ismailozgenc/FPGA-Based-Spoken-Number-Recognition-System/docs/fig_system_block_diagram.png

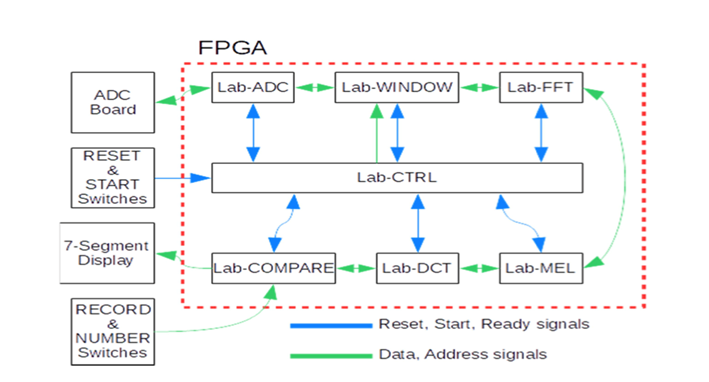
docs/fig_system_block_diagram.png
