ismailozgenc/FPGA-Based-Spoken-Number-Recognition-System/docs/pcbreel.jpeg

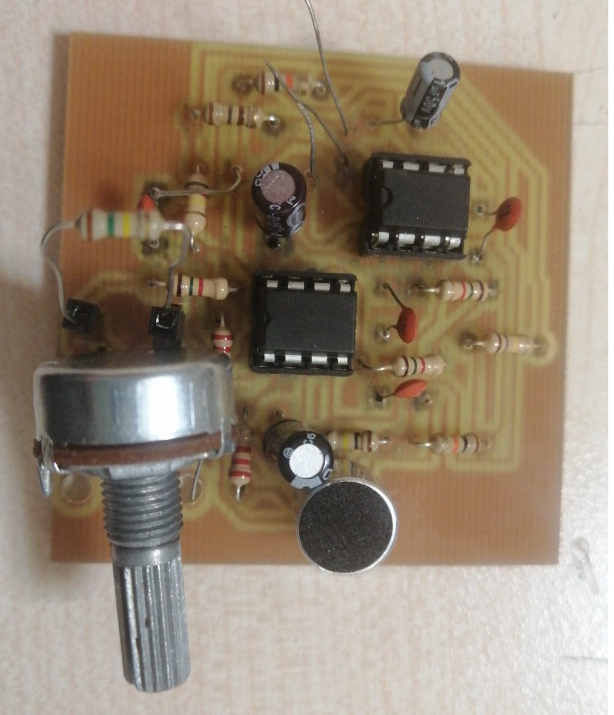
docs/pcbreel.jpeg
