ismailozgenc/FPGA-Based-Spoken-Number-Recognition-System/docs/SNRinFPGA.jpeg

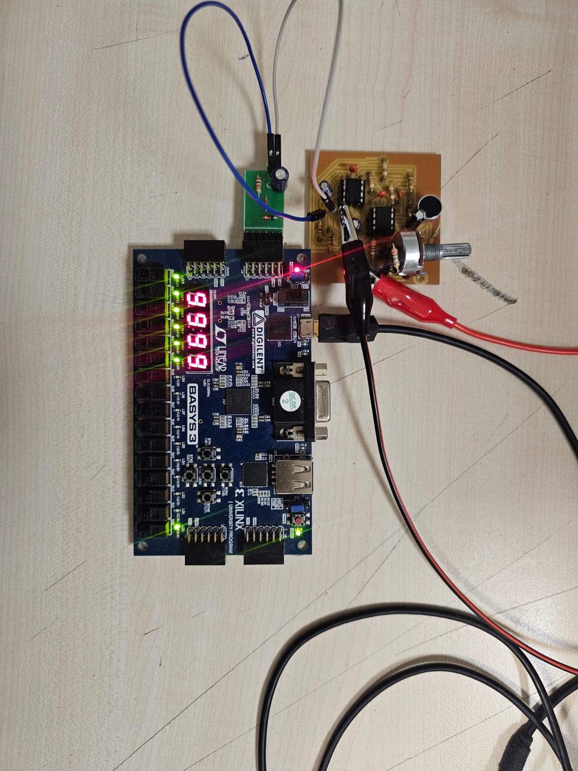
docs/SNRinFPGA.jpeg
