ismailozgenc/FPGA-Based-Spoken-Number-Recognition-System/hardware/Analog front-end schematic.png

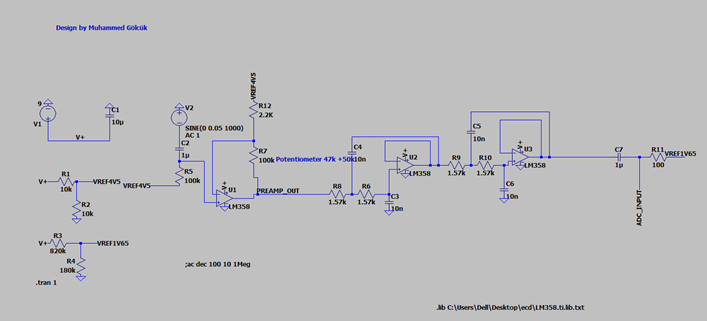
hardware/Analog front-end schematic.png
