ismailozgenc/FPGA-Based-Spoken-Number-Recognition-System/Matlab Codes/images/adc_.png

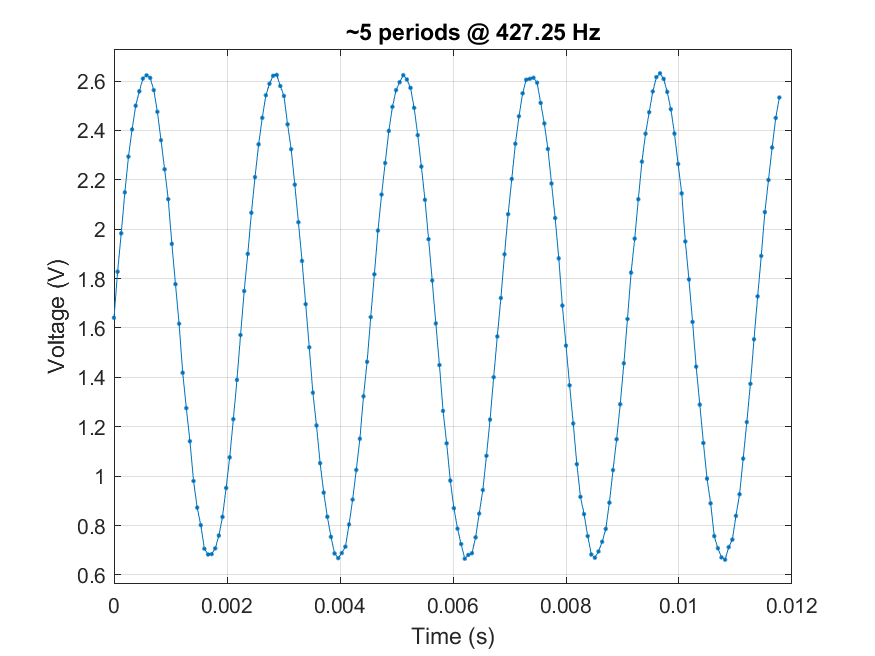
Matlab Codes/images/adc_.png
