ismailozgenc/FPGA-Based-Spoken-Number-Recognition-System/Matlab Codes/images/adc_vin.png

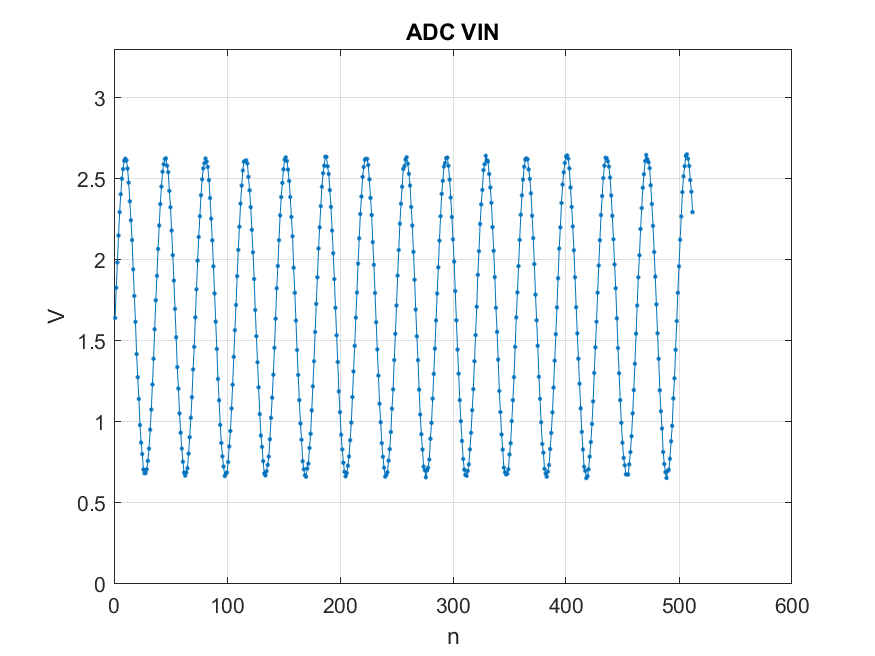
Matlab Codes/images/adc_vin.png
