ismailozgenc/FPGA-Based-Spoken-Number-Recognition-System/Matlab Codes/images/adc_vin_.png

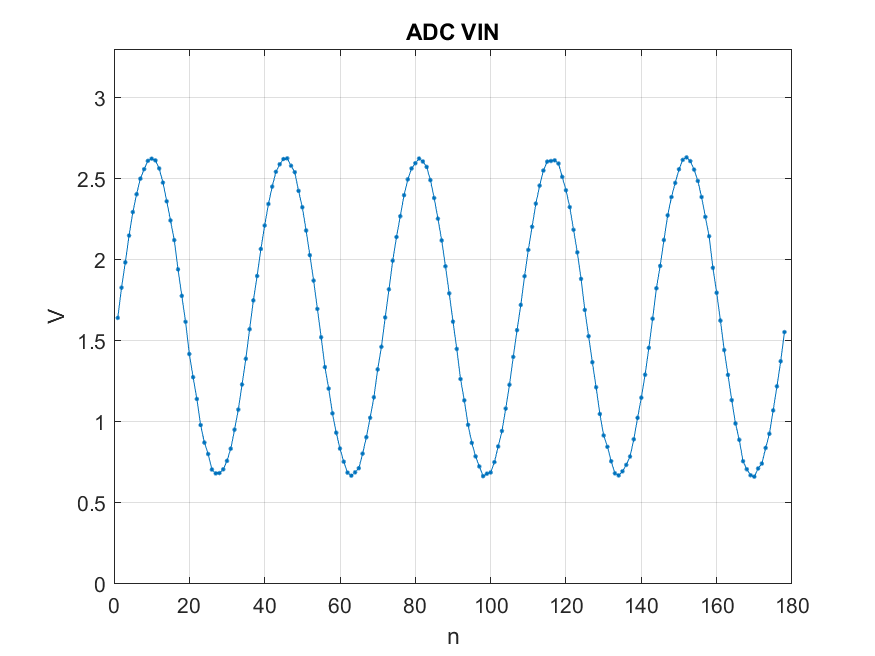
Matlab Codes/images/adc_vin_.png
