ismailozgenc/FPGA-Based-Spoken-Number-Recognition-System/Matlab Codes/images/dct_8.png

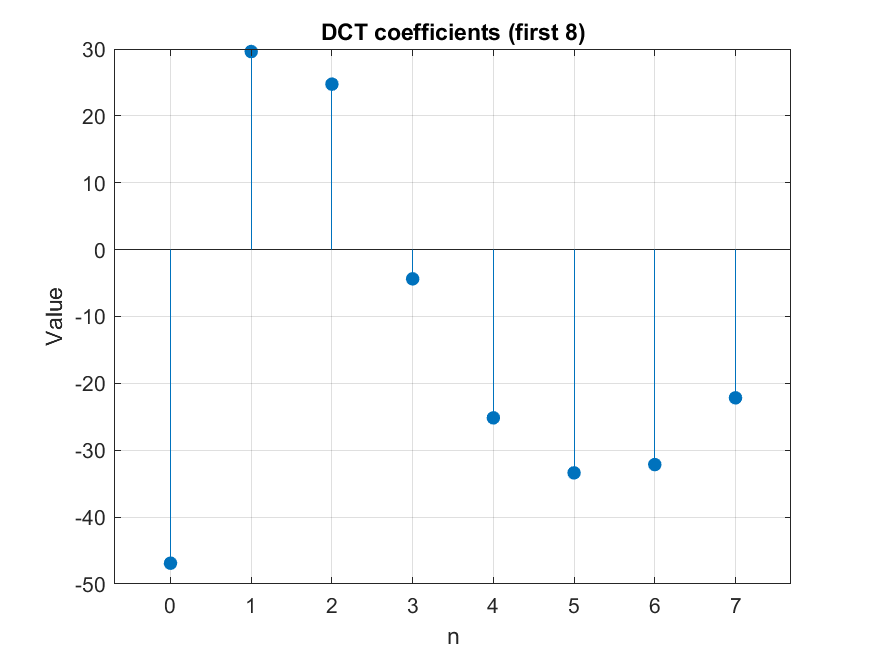
Matlab Codes/images/dct_8.png
