ismailozgenc/FPGA-Based-Spoken-Number-Recognition-System/Matlab Codes/images/fft_mags2_bins_0_255.png

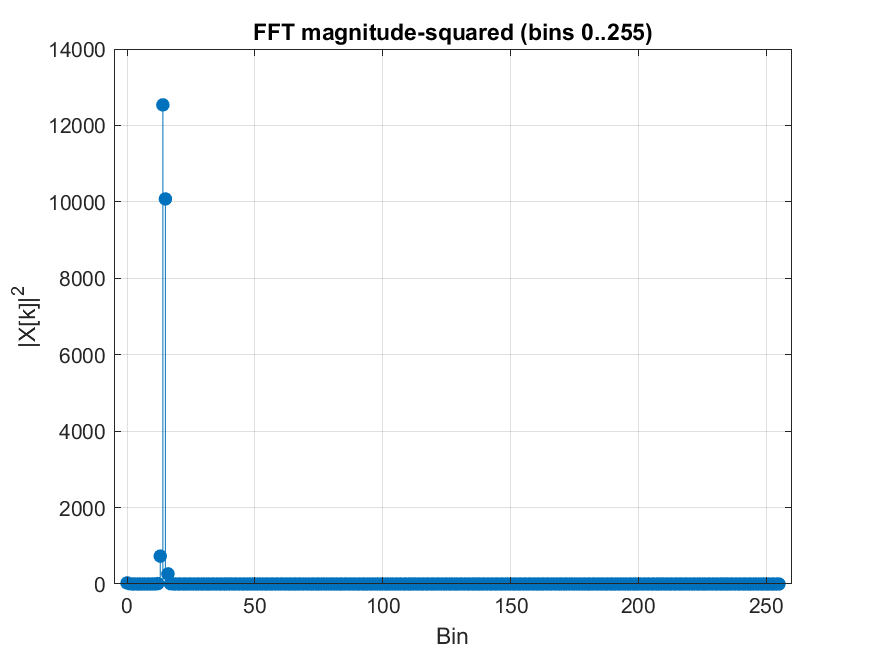
Matlab Codes/images/fft_mags2_bins_0_255.png
