ismailozgenc/FPGA-Based-Spoken-Number-Recognition-System/Matlab Codes/images/fft_spectrum_db.png

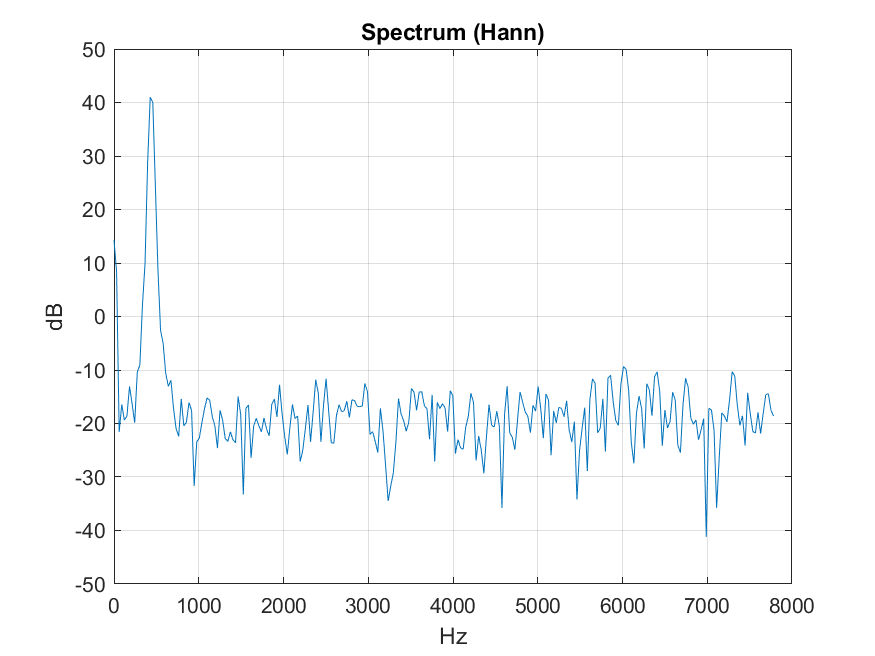
Matlab Codes/images/fft_spectrum_db.png
