ismailozgenc/FPGA-Based-Spoken-Number-Recognition-System/Matlab Codes/images/mel_energies.png

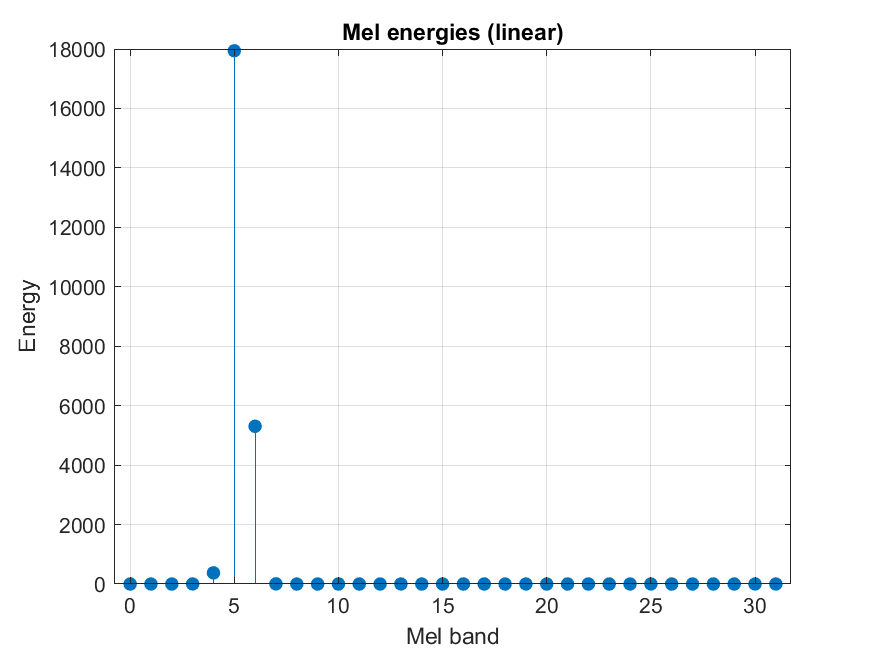
Matlab Codes/images/mel_energies.png
