ismailozgenc/FPGA-Based-Spoken-Number-Recognition-System/Matlab Codes/images/mel_log.png

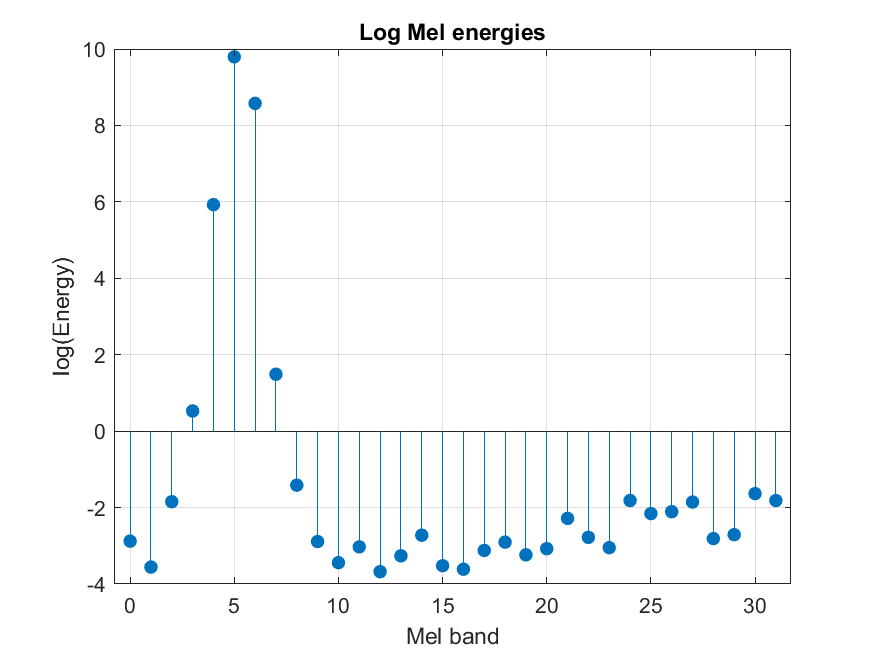
Matlab Codes/images/mel_log.png
