ismailozgenc/FPGA-Based-Spoken-Number-Recognition-System/Matlab Codes/images/windowed.png

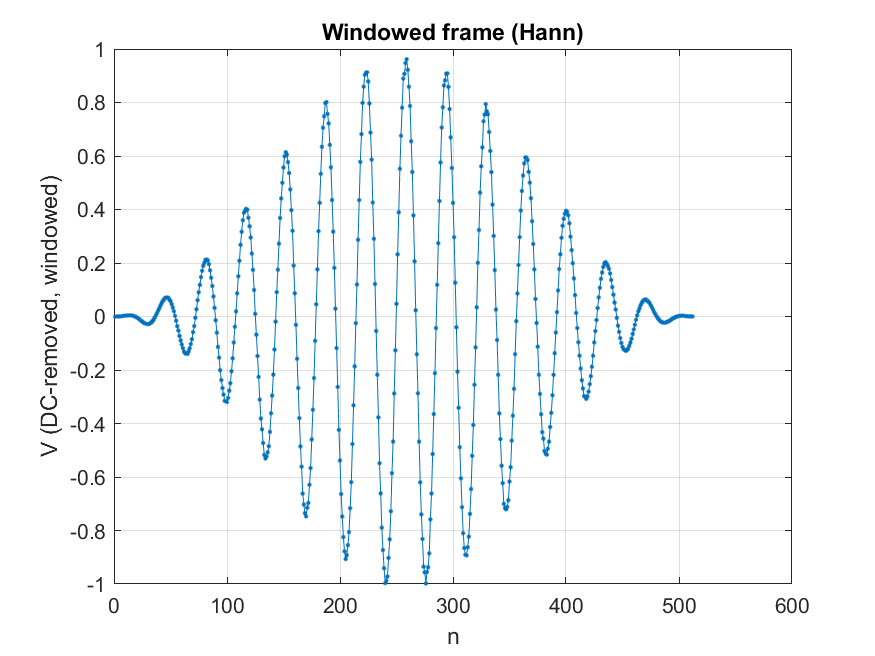
Matlab Codes/images/windowed.png
