ismailozgenc/FPGA-Based-Spoken-Number-Recognition-System/IPs/IP-Lab_MEL/src/Lab_MEL.vhd

library ieee;
use ieee.std_logic_1164.all;
use ieee.numeric_std.all;

entity Lab_MEL is
    port (
        reset_in     : in  std_logic;
        clock_in     : in  std_logic;
        fft_addr_out : out std_logic_vector(7 downto 0);
        fft_data_in  : in  std_logic_vector(31 downto 0);
        mem_addr_in  : in  std_logic_vector(4 downto 0);
        mem_data_out : out std_logic_vector(31 downto 0);
        start_in     : in  std_logic;
        ready_out    : out std_logic
    );
end entity;

architecture rtl of Lab_MEL is

    constant NUM_FILTERS : integer := 32;
    constant NUM_BINS    : integer := 256;
    constant COEF_WIDTH  : integer := 12;
    constant ACC_WIDTH   : integer := 48;

    type coeff_row_t is array (0 to NUM_BINS-1) of signed(COEF_WIDTH-1 downto 0);
    type coeff_rom_t is array (0 to NUM_FILTERS-1) of coeff_row_t;

    constant coeff_rom : coeff_rom_t := (
        0 => (to_signed(2047, COEF_WIDTH), to_signed(1024, COEF_WIDTH), to_signed(0, COEF_WIDTH), to_signed(0, COEF_WIDTH), to_signed(0, COEF_WIDTH), to_signed(0, COEF_WIDTH), to_signed(0, COEF_WIDTH), to_signed(0, COEF_WIDTH), to_signed(0, COEF_WIDTH), to_signed(0, COEF_WIDTH), to_signed(0, COEF_WIDTH), to_signed(0, COEF_WIDTH), to_signed(0, COEF_WIDTH), to_signed(0, COEF_WIDTH), to_signed(0, COEF_WIDTH), to_signed(0, COEF_WIDTH), to_signed(0, COEF_WIDTH), to_signed(0, COEF_WIDTH), to_signed(0, COEF_WIDTH), to_signed(0, COEF_WIDTH), to_signed(0, COEF_WIDTH), to_signed(0, COEF_WIDTH), to_signed(0, COEF_WIDTH), to_signed(0, COEF_WIDTH), to_signed(0, COEF_WIDTH), to_signed(0, COEF_WIDTH), to_signed(0, COEF_WIDTH), to_signed(0, COEF_WIDTH), to_signed(0, COEF_WIDTH), to_signed(0, COEF_WIDTH), to_signed(0, COEF_WIDTH), to_signed(0, COEF_WIDTH), to_signed(0, COEF_WIDTH), to_signed(0, COEF_WIDTH), to_signed(0, COEF_WIDTH), to_signed(0, COEF_WIDTH), to_signed(0, COEF_WIDTH), to_signed(0, COEF_WIDTH), to_signed(0, COEF_WIDTH), to_signed(0, COEF_WIDTH), to_signed(0, COEF_WIDTH), to_signed(0, COEF_WIDTH), to_signed(0, COEF_WIDTH), to_signed(0, COEF_WIDTH), to_signed(0, COEF_WIDTH), to_signed(0, COEF_WIDTH), to_signed(0, COEF_WIDTH), to_signed(0, COEF_WIDTH), to_signed(0, COEF_WIDTH), to_signed(0, COEF_WIDTH), to_signed(0, COEF_WIDTH), to_signed(0, COEF_WIDTH), to_signed(0, COEF_WIDTH), to_signed(0, COEF_WIDTH), to_signed(0, COEF_WIDTH), to_signed(0, COEF_WIDTH), to_signed(0, COEF_WIDTH)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
to_signed(0, COEF_WIDTH), to_signed(0, COEF_WIDTH), to_signed(0, COEF_WIDTH), to_signed(0, COEF_WIDTH), to_signed(0, COEF_WIDTH), to_signed(0, COEF_WIDTH), to_signed(0, COEF_WIDTH), to_signed(0, COEF_WIDTH), to_signed(0, COEF_WIDTH), to_signed(0, COEF_WIDTH), to_signed(0, COEF_WIDTH), to_signed(0, COEF_WIDTH), to_signed(0, COEF_WIDTH), to_signed(0, COEF_WIDTH), to_signed(0, COEF_WIDTH), to_signed(0, COEF_WIDTH), to_signed(0, COEF_WIDTH), to_signed(0, COEF_WIDTH), to_signed(0, COEF_WIDTH), to_signed(0, COEF_WIDTH), to_signed(0, COEF_WIDTH), to_signed(0, COEF_WIDTH), to_signed(0, COEF_WIDTH), to_signed(0, COEF_WIDTH), to_signed(0, COEF_WIDTH), to_signed(0, COEF_WIDTH)),
        1 => (to_signed(0, COEF_WIDTH), to_signed(1024, COEF_WIDTH), to_signed(2047, COEF_WIDTH), to_signed(1024, COEF_WIDTH), to_signed(0, COEF_WIDTH), to_signed(0, COEF_WIDTH), to_signed(0, COEF_WIDTH), to_signed(0, COEF_WIDTH), to_signed(0, COEF_WIDTH), to_signed(0, COEF_WIDTH), to_signed(0, COEF_WIDTH), to_signed(0, COEF_WIDTH), to_signed(0, COEF_WIDTH), to_signed(0, COEF_WIDTH), to_signed(0, COEF_WIDTH), to_signed(0, COEF_WIDTH), to_signed(0, COEF_WIDTH), to_signed(0, COEF_WIDTH), to_signed(0, COEF_WIDTH), to_signed(0, COEF_WIDTH), to_signed(0, COEF_WIDTH), to_signed(0, COEF_WIDTH), to_signed(0, COEF_WIDTH), to_signed(0, COEF_WIDTH), to_signed(0, COEF_WIDTH), to_signed(0, COEF_WIDTH), to_signed(0, COEF_WIDTH), to_signed(0, COEF_WIDTH), to_signed(0, COEF_WIDTH), to_signed(0, COEF_WIDTH), to_signed(0, COEF_WIDTH), to_signed(0, COEF_WIDTH), to_signed(0, COEF_WIDTH), to_signed(0, COEF_WIDTH), to_signed(0, COEF_WIDTH), to_signed(0, COEF_WIDTH), to_signed(0, COEF_WIDTH), to_signed(0, COEF_WIDTH), to_signed(0, COEF_WIDTH), to_signed(0, COEF_WIDTH), to_signed(0, COEF_WIDTH), to_signed(0, COEF_WIDTH), to_signed(0, COEF_WIDTH), to_signed(0, COEF_WIDTH), to_signed(0, COEF_WIDTH), to_signed(0, COEF_WIDTH), to_signed(0, COEF_WIDTH), to_signed(0, COEF_WIDTH), to_signed(0, COEF_WIDTH), to_signed(0, COEF_WIDTH), to_signed(0, COEF_WIDTH), to_signed(0, COEF_WIDTH), to_signed(0, COEF_WIDTH), to_signed(0, COEF_WIDTH), to_signed(0, COEF_WIDTH), to_signed(0, COEF_WIDTH), to_signed(0, COEF_WID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
), to_signed(0, COEF_WIDTH), to_signed(0, COEF_WIDTH), to_signed(0, COEF_WIDTH), to_signed(0, COEF_WIDTH), to_signed(0, COEF_WIDTH), to_signed(0, COEF_WIDTH), to_signed(0, COEF_WIDTH), to_signed(0, COEF_WIDTH), to_signed(0, COEF_WIDTH), to_signed(0, COEF_WIDTH), to_signed(0, COEF_WIDTH), to_signed(0, COEF_WIDTH), to_signed(0, COEF_WIDTH), to_signed(0, COEF_WIDTH), to_signed(0, COEF_WIDTH), to_signed(0, COEF_WIDTH), to_signed(0, COEF_WIDTH), to_signed(0, COEF_WIDTH), to_signed(0, COEF_WIDTH), to_signed(0, COEF_WIDTH), to_signed(0, COEF_WIDTH), to_signed(0, COEF_WIDTH), to_signed(0, COEF_WIDTH), to_signed(0, COEF_WIDTH), to_signed(0, COEF_WIDTH), to_signed(0, COEF_WIDTH)),
        2 => (to_signed(0, COEF_WIDTH), to_signed(0, COEF_WIDTH), to_signed(0, COEF_WIDTH), to_signed(1024, COEF_WIDTH), to_signed(2047, COEF_WIDTH), to_signed(1365, COEF_WIDTH), to_signed(683, COEF_WIDTH), to_signed(0, COEF_WIDTH), to_signed(0, COEF_WIDTH), to_signed(0, COEF_WIDTH), to_signed(0, COEF_WIDTH), to_signed(0, COEF_WIDTH), to_signed(0, COEF_WIDTH), to_signed(0, COEF_WIDTH), to_signed(0, COEF_WIDTH), to_signed(0, COEF_WIDTH), to_signed(0, COEF_WIDTH), to_signed(0, COEF_WIDTH), to_signed(0, COEF_WIDTH), to_signed(0, COEF_WIDTH), to_signed(0, COEF_WIDTH), to_signed(0, COEF_WIDTH), to_signed(0, COEF_WIDTH), to_signed(0, COEF_WIDTH), to_signed(0, COEF_WIDTH), to_signed(0, COEF_WIDTH), to_signed(0, COEF_WIDTH), to_signed(0, COEF_WIDTH), to_signed(0, COEF_WIDTH), to_signed(0, COEF_WIDTH), to_signed(0, COEF_WIDTH), to_signed(0, COEF_WIDTH), to_signed(0, COEF_WIDTH), to_signed(0, COEF_WIDTH), to_signed(0, COEF_WIDTH), to_signed(0, COEF_WIDTH), to_signed(0, COEF_WIDTH), to_signed(0, COEF_WIDTH), to_signed(0, COEF_WIDTH), to_signed(0, COEF_WIDTH), to_signed(0, COEF_WIDTH), to_signed(0, COEF_WIDTH), to_signed(0, COEF_WIDTH), to_signed(0, COEF_WIDTH), to_signed(0, COEF_WIDTH), to_signed(0, COEF_WIDTH), to_signed(0, COEF_WIDTH), to_signed(0, COEF_WIDTH), to_signed(0, COEF_WIDTH), to_signed(0, COEF_WIDTH), to_signed(0, COEF_WIDTH), to_signed(0, COEF_WIDTH), to_signed(0, COEF_WIDTH), to_signed(0, COEF_WIDTH), to_signed(0, COEF_WIDTH), to_signed(0, COEF_WIDTH), to_signed(0, COEF_W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
TH), to_signed(0, COEF_WIDTH), to_signed(0, COEF_WIDTH), to_signed(0, COEF_WIDTH), to_signed(0, COEF_WIDTH), to_signed(0, COEF_WIDTH), to_signed(0, COEF_WIDTH), to_signed(0, COEF_WIDTH), to_signed(0, COEF_WIDTH), to_signed(0, COEF_WIDTH), to_signed(0, COEF_WIDTH), to_signed(0, COEF_WIDTH), to_signed(0, COEF_WIDTH), to_signed(0, COEF_WIDTH), to_signed(0, COEF_WIDTH), to_signed(0, COEF_WIDTH), to_signed(0, COEF_WIDTH), to_signed(0, COEF_WIDTH), to_signed(0, COEF_WIDTH), to_signed(0, COEF_WIDTH), to_signed(0, COEF_WIDTH), to_signed(0, COEF_WIDTH), to_signed(0, COEF_WIDTH), to_signed(0, COEF_WIDTH), to_signed(0, COEF_WIDTH), to_signed(0, COEF_WIDTH), to_signed(0, COEF_WIDTH)),
        3 => (to_signed(0, COEF_WIDTH), to_signed(0, COEF_WIDTH), to_signed(0, COEF_WIDTH), to_signed(0, COEF_WIDTH), to_signed(0, COEF_WIDTH), to_signed(683, COEF_WIDTH), to_signed(1365, COEF_WIDTH), to_signed(2047, COEF_WIDTH), to_signed(1024, COEF_WIDTH), to_signed(0, COEF_WIDTH), to_signed(0, COEF_WIDTH), to_signed(0, COEF_WIDTH), to_signed(0, COEF_WIDTH), to_signed(0, COEF_WIDTH), to_signed(0, COEF_WIDTH), to_signed(0, COEF_WIDTH), to_signed(0, COEF_WIDTH), to_signed(0, COEF_WIDTH), to_signed(0, COEF_WIDTH), to_signed(0, COEF_WIDTH), to_signed(0, COEF_WIDTH), to_signed(0, COEF_WIDTH), to_signed(0, COEF_WIDTH), to_signed(0, COEF_WIDTH), to_signed(0, COEF_WIDTH), to_signed(0, COEF_WIDTH), to_signed(0, COEF_WIDTH), to_signed(0, COEF_WIDTH), to_signed(0, COEF_WIDTH), to_signed(0, COEF_WIDTH), to_signed(0, COEF_WIDTH), to_signed(0, COEF_WIDTH), to_signed(0, COEF_WIDTH), to_signed(0, COEF_WIDTH), to_signed(0, COEF_WIDTH), to_signed(0, COEF_WIDTH), to_signed(0, COEF_WIDTH), to_signed(0, COEF_WIDTH), to_signed(0, COEF_WIDTH), to_signed(0, COEF_WIDTH), to_signed(0, COEF_WIDTH), to_signed(0, COEF_WIDTH), to_signed(0, COEF_WIDTH), to_signed(0, COEF_WIDTH), to_signed(0, COEF_WIDTH), to_signed(0, COEF_WIDTH), to_signed(0, COEF_WIDTH), to_signed(0, COEF_WIDTH), to_signed(0, COEF_WIDTH), to_signed(0, COEF_WIDTH), to_signed(0, COEF_WIDTH), to_signed(0, COEF_WIDTH), to_signed(0, COEF_WIDTH), to_signed(0, COEF_WIDTH), to_signed(0, COEF_WIDTH), to_signed(0, COEF_WIDTH), to_signed(0, COEF_W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
TH), to_signed(0, COEF_WIDTH), to_signed(0, COEF_WIDTH), to_signed(0, COEF_WIDTH), to_signed(0, COEF_WIDTH), to_signed(0, COEF_WIDTH), to_signed(0, COEF_WIDTH), to_signed(0, COEF_WIDTH), to_signed(0, COEF_WIDTH), to_signed(0, COEF_WIDTH), to_signed(0, COEF_WIDTH), to_signed(0, COEF_WIDTH), to_signed(0, COEF_WIDTH), to_signed(0, COEF_WIDTH), to_signed(0, COEF_WIDTH), to_signed(0, COEF_WIDTH), to_signed(0, COEF_WIDTH), to_signed(0, COEF_WIDTH), to_signed(0, COEF_WIDTH), to_signed(0, COEF_WIDTH), to_signed(0, COEF_WIDTH), to_signed(0, COEF_WIDTH), to_signed(0, COEF_WIDTH), to_signed(0, COEF_WIDTH), to_signed(0, COEF_WIDTH), to_signed(0, COEF_WIDTH), to_signed(0, COEF_WIDTH)),
        4 => (to_signed(0, COEF_WIDTH), to_signed(0, COEF_WIDTH), to_signed(0, COEF_WIDTH), to_signed(0, COEF_WIDTH), to_signed(0, COEF_WIDTH), to_signed(0, COEF_WIDTH), to_signed(0, COEF_WIDTH), to_signed(0, COEF_WIDTH), to_signed(1024, COEF_WIDTH), to_signed(2047, COEF_WIDTH), to_signed(1365, COEF_WIDTH), to_signed(683, COEF_WIDTH), to_signed(0, COEF_WIDTH), to_signed(0, COEF_WIDTH), to_signed(0, COEF_WIDTH), to_signed(0, COEF_WIDTH), to_signed(0, COEF_WIDTH), to_signed(0, COEF_WIDTH), to_signed(0, COEF_WIDTH), to_signed(0, COEF_WIDTH), to_signed(0, COEF_WIDTH), to_signed(0, COEF_WIDTH), to_signed(0, COEF_WIDTH), to_signed(0, COEF_WIDTH), to_signed(0, COEF_WIDTH), to_signed(0, COEF_WIDTH), to_signed(0, COEF_WIDTH), to_signed(0, COEF_WIDTH), to_signed(0, COEF_WIDTH), to_signed(0, COEF_WIDTH), to_signed(0, COEF_WIDTH), to_signed(0, COEF_WIDTH), to_signed(0, COEF_WIDTH), to_signed(0, COEF_WIDTH), to_signed(0, COEF_WIDTH), to_signed(0, COEF_WIDTH), to_signed(0, COEF_WIDTH), to_signed(0, COEF_WIDTH), to_signed(0, COEF_WIDTH), to_signed(0, COEF_WIDTH), to_signed(0, COEF_WIDTH), to_signed(0, COEF_WIDTH), to_signed(0, COEF_WIDTH), to_signed(0, COEF_WIDTH), to_signed(0, COEF_WIDTH), to_signed(0, COEF_WIDTH), to_signed(0, COEF_WIDTH), to_signed(0, COEF_WIDTH), to_signed(0, COEF_WIDTH), to_signed(0, COEF_WIDTH), to_signed(0, COEF_WIDTH), to_signed(0, COEF_WIDTH), to_signed(0, COEF_WIDTH), to_signed(0, COEF_WIDTH), to_signed(0, COEF_WIDTH), to_signed(0, COEF_WIDTH), to_signed(0, COEF_W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
TH), to_signed(0, COEF_WIDTH), to_signed(0, COEF_WIDTH), to_signed(0, COEF_WIDTH), to_signed(0, COEF_WIDTH), to_signed(0, COEF_WIDTH), to_signed(0, COEF_WIDTH), to_signed(0, COEF_WIDTH), to_signed(0, COEF_WIDTH), to_signed(0, COEF_WIDTH), to_signed(0, COEF_WIDTH), to_signed(0, COEF_WIDTH), to_signed(0, COEF_WIDTH), to_signed(0, COEF_WIDTH), to_signed(0, COEF_WIDTH), to_signed(0, COEF_WIDTH), to_signed(0, COEF_WIDTH), to_signed(0, COEF_WIDTH), to_signed(0, COEF_WIDTH), to_signed(0, COEF_WIDTH), to_signed(0, COEF_WIDTH), to_signed(0, COEF_WIDTH), to_signed(0, COEF_WIDTH), to_signed(0, COEF_WIDTH), to_signed(0, COEF_WIDTH), to_signed(0, COEF_WIDTH), to_signed(0, COEF_WIDTH)),
        5 => (to_signed(0, COEF_WIDTH), to_signed(0, COEF_WIDTH), to_signed(0, COEF_WIDTH), to_signed(0, COEF_WIDTH), to_signed(0, COEF_WIDTH), to_signed(0, COEF_WIDTH), to_signed(0, COEF_WIDTH), to_signed(0, COEF_WIDTH), to_signed(0, COEF_WIDTH), to_signed(0, COEF_WIDTH), to_signed(683, COEF_WIDTH), to_signed(1365, COEF_WIDTH), to_signed(2047, COEF_WIDTH), to_signed(1024, COEF_WIDTH), to_signed(0, COEF_WIDTH), to_signed(0, COEF_WIDTH), to_signed(0, COEF_WIDTH), to_signed(0, COEF_WIDTH), to_signed(0, COEF_WIDTH), to_signed(0, COEF_WIDTH), to_signed(0, COEF_WIDTH), to_signed(0, COEF_WIDTH), to_signed(0, COEF_WIDTH), to_signed(0, COEF_WIDTH), to_signed(0, COEF_WIDTH), to_signed(0, COEF_WIDTH), to_signed(0, COEF_WIDTH), to_signed(0, COEF_WIDTH), to_signed(0, COEF_WIDTH), to_signed(0, COEF_WIDTH), to_signed(0, COEF_WIDTH), to_signed(0, COEF_WIDTH), to_signed(0, COEF_WIDTH), to_signed(0, COEF_WIDTH), to_signed(0, COEF_WIDTH), to_signed(0, COEF_WIDTH), to_signed(0, COEF_WIDTH), to_signed(0, COEF_WIDTH), to_signed(0, COEF_WIDTH), to_signed(0, COEF_WIDTH), to_signed(0, COEF_WIDTH), to_signed(0, COEF_WIDTH), to_signed(0, COEF_WIDTH), to_signed(0, COEF_WIDTH), to_signed(0, COEF_WIDTH), to_signed(0, COEF_WIDTH), to_signed(0, COEF_WIDTH), to_signed(0, COEF_WIDTH), to_signed(0, COEF_WIDTH), to_signed(0, COEF_WIDTH), to_signed(0, COEF_WIDTH), to_signed(0, COEF_WIDTH), to_signed(0, COEF_WIDTH), to_signed(0, COEF_WIDTH), to_signed(0, COEF_WIDTH), to_signed(0, COEF_WIDTH), to_signed(0, COEF_W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
TH), to_signed(0, COEF_WIDTH), to_signed(0, COEF_WIDTH), to_signed(0, COEF_WIDTH), to_signed(0, COEF_WIDTH), to_signed(0, COEF_WIDTH), to_signed(0, COEF_WIDTH), to_signed(0, COEF_WIDTH), to_signed(0, COEF_WIDTH), to_signed(0, COEF_WIDTH), to_signed(0, COEF_WIDTH), to_signed(0, COEF_WIDTH), to_signed(0, COEF_WIDTH), to_signed(0, COEF_WIDTH), to_signed(0, COEF_WIDTH), to_signed(0, COEF_WIDTH), to_signed(0, COEF_WIDTH), to_signed(0, COEF_WIDTH), to_signed(0, COEF_WIDTH), to_signed(0, COEF_WIDTH), to_signed(0, COEF_WIDTH), to_signed(0, COEF_WIDTH), to_signed(0, COEF_WIDTH), to_signed(0, COEF_WIDTH), to_signed(0, COEF_WIDTH), to_signed(0, COEF_WIDTH), to_signed(0, COEF_WIDTH)),
        6 => (to_signed(0, COEF_WIDTH), to_signed(0, COEF_WIDTH), to_signed(0, COEF_WIDTH), to_signed(0, COEF_WIDTH), to_signed(0, COEF_WIDTH), to_signed(0, COEF_WIDTH), to_signed(0, COEF_WIDTH), to_signed(0, COEF_WIDTH), to_signed(0, COEF_WIDTH), to_signed(0, COEF_WIDTH), to_signed(0, COEF_WIDTH), to_signed(0, COEF_WIDTH), to_signed(0, COEF_WIDTH), to_signed(1024, COEF_WIDTH), to_signed(2047, COEF_WIDTH), to_signed(1365, COEF_WIDTH), to_signed(683, COEF_WIDTH), to_signed(0, COEF_WIDTH), to_signed(0, COEF_WIDTH), to_signed(0, COEF_WIDTH), to_signed(0, COEF_WIDTH), to_signed(0, COEF_WIDTH), to_signed(0, COEF_WIDTH), to_signed(0, COEF_WIDTH), to_signed(0, COEF_WIDTH), to_signed(0, COEF_WIDTH), to_signed(0, COEF_WIDTH), to_signed(0, COEF_WIDTH), to_signed(0, COEF_WIDTH), to_signed(0, COEF_WIDTH), to_signed(0, COEF_WIDTH), to_signed(0, COEF_WIDTH), to_signed(0, COEF_WIDTH), to_signed(0, COEF_WIDTH), to_signed(0, COEF_WIDTH), to_signed(0, COEF_WIDTH), to_signed(0, COEF_WIDTH), to_signed(0, COEF_WIDTH), to_signed(0, COEF_WIDTH), to_signed(0, COEF_WIDTH), to_signed(0, COEF_WIDTH), to_signed(0, COEF_WIDTH), to_signed(0, COEF_WIDTH), to_signed(0, COEF_WIDTH), to_signed(0, COEF_WIDTH), to_signed(0, COEF_WIDTH), to_signed(0, COEF_WIDTH), to_signed(0, COEF_WIDTH), to_signed(0, COEF_WIDTH), to_signed(0, COEF_WIDTH), to_signed(0, COEF_WIDTH), to_signed(0, COEF_WIDTH), to_signed(0, COEF_WIDTH), to_signed(0, COEF_WIDTH), to_signed(0, COEF_WIDTH), to_signed(0, COEF_WIDTH), to_signed(0, COEF_W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
TH), to_signed(0, COEF_WIDTH), to_signed(0, COEF_WIDTH), to_signed(0, COEF_WIDTH), to_signed(0, COEF_WIDTH), to_signed(0, COEF_WIDTH), to_signed(0, COEF_WIDTH), to_signed(0, COEF_WIDTH), to_signed(0, COEF_WIDTH), to_signed(0, COEF_WIDTH), to_signed(0, COEF_WIDTH), to_signed(0, COEF_WIDTH), to_signed(0, COEF_WIDTH), to_signed(0, COEF_WIDTH), to_signed(0, COEF_WIDTH), to_signed(0, COEF_WIDTH), to_signed(0, COEF_WIDTH), to_signed(0, COEF_WIDTH), to_signed(0, COEF_WIDTH), to_signed(0, COEF_WIDTH), to_signed(0, COEF_WIDTH), to_signed(0, COEF_WIDTH), to_signed(0, COEF_WIDTH), to_signed(0, COEF_WIDTH), to_signed(0, COEF_WIDTH), to_signed(0, COEF_WIDTH), to_signed(0, COEF_WIDTH)),
        7 => (to_signed(0, COEF_WIDTH), to_signed(0, COEF_WIDTH), to_signed(0, COEF_WIDTH), to_signed(0, COEF_WIDTH), to_signed(0, COEF_WIDTH), to_signed(0, COEF_WIDTH), to_signed(0, COEF_WIDTH), to_signed(0, COEF_WIDTH), to_signed(0, COEF_WIDTH), to_signed(0, COEF_WIDTH), to_signed(0, COEF_WIDTH), to_signed(0, COEF_WIDTH), to_signed(0, COEF_WIDTH), to_signed(0, COEF_WIDTH), to_signed(0, COEF_WIDTH), to_signed(683, COEF_WIDTH), to_signed(1365, COEF_WIDTH), to_signed(2047, COEF_WIDTH), to_signed(1536, COEF_WIDTH), to_signed(1024, COEF_WIDTH), to_signed(512, COEF_WIDTH), to_signed(0, COEF_WIDTH), to_signed(0, COEF_WIDTH), to_signed(0, COEF_WIDTH), to_signed(0, COEF_WIDTH), to_signed(0, COEF_WIDTH), to_signed(0, COEF_WIDTH), to_signed(0, COEF_WIDTH), to_signed(0, COEF_WIDTH), to_signed(0, COEF_WIDTH), to_signed(0, COEF_WIDTH), to_signed(0, COEF_WIDTH), to_signed(0, COEF_WIDTH), to_signed(0, COEF_WIDTH), to_signed(0, COEF_WIDTH), to_signed(0, COEF_WIDTH), to_signed(0, COEF_WIDTH), to_signed(0, COEF_WIDTH), to_signed(0, COEF_WIDTH), to_signed(0, COEF_WIDTH), to_signed(0, COEF_WIDTH), to_signed(0, COEF_WIDTH), to_signed(0, COEF_WIDTH), to_signed(0, COEF_WIDTH), to_signed(0, COEF_WIDTH), to_signed(0, COEF_WIDTH), to_signed(0, COEF_WIDTH), to_signed(0, COEF_WIDTH), to_signed(0, COEF_WIDTH), to_signed(0, COEF_WIDTH), to_signed(0, COEF_WIDTH), to_signed(0, COEF_WIDTH), to_signed(0, COEF_WIDTH), to_signed(0, COEF_WIDTH), to_signed(0, COEF_WIDTH), to_signed(0, COEF_WIDTH), to_signed(0, C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
F_WIDTH), to_signed(0, COEF_WIDTH), to_signed(0, COEF_WIDTH), to_signed(0, COEF_WIDTH), to_signed(0, COEF_WIDTH), to_signed(0, COEF_WIDTH), to_signed(0, COEF_WIDTH), to_signed(0, COEF_WIDTH), to_signed(0, COEF_WIDTH), to_signed(0, COEF_WIDTH), to_signed(0, COEF_WIDTH), to_signed(0, COEF_WIDTH), to_signed(0, COEF_WIDTH), to_signed(0, COEF_WIDTH), to_signed(0, COEF_WIDTH), to_signed(0, COEF_WIDTH), to_signed(0, COEF_WIDTH), to_signed(0, COEF_WIDTH), to_signed(0, COEF_WIDTH), to_signed(0, COEF_WIDTH), to_signed(0, COEF_WIDTH), to_signed(0, COEF_WIDTH), to_signed(0, COEF_WIDTH), to_signed(0, COEF_WIDTH), to_signed(0, COEF_WIDTH), to_signed(0, COEF_WIDTH), to_signed(0, COEF_WIDTH)),
        8 => (to_signed(0, COEF_WIDTH), to_signed(0, COEF_WIDTH), to_signed(0, COEF_WIDTH), to_signed(0, COEF_WIDTH), to_signed(0, COEF_WIDTH), to_signed(0, COEF_WIDTH), to_signed(0, COEF_WIDTH), to_signed(0, COEF_WIDTH), to_signed(0, COEF_WIDTH), to_signed(0, COEF_WIDTH), to_signed(0, COEF_WIDTH), to_signed(0, COEF_WIDTH), to_signed(0, COEF_WIDTH), to_signed(0, COEF_WIDTH), to_signed(0, COEF_WIDTH), to_signed(0, COEF_WIDTH), to_signed(0, COEF_WIDTH), to_signed(0, COEF_WIDTH), to_signed(512, COEF_WIDTH), to_signed(1024, COEF_WIDTH), to_signed(1536, COEF_WIDTH), to_signed(2047, COEF_WIDTH), to_signed(1365, COEF_WIDTH), to_signed(683, COEF_WIDTH), to_signed(0, COEF_WIDTH), to_signed(0, COEF_WIDTH), to_signed(0, COEF_WIDTH), to_signed(0, COEF_WIDTH), to_signed(0, COEF_WIDTH), to_signed(0, COEF_WIDTH), to_signed(0, COEF_WIDTH), to_signed(0, COEF_WIDTH), to_signed(0, COEF_WIDTH), to_signed(0, COEF_WIDTH), to_signed(0, COEF_WIDTH), to_signed(0, COEF_WIDTH), to_signed(0, COEF_WIDTH), to_signed(0, COEF_WIDTH), to_signed(0, COEF_WIDTH), to_signed(0, COEF_WIDTH), to_signed(0, COEF_WIDTH), to_signed(0, COEF_WIDTH), to_signed(0, COEF_WIDTH), to_signed(0, COEF_WIDTH), to_signed(0, COEF_WIDTH), to_signed(0, COEF_WIDTH), to_signed(0, COEF_WIDTH), to_signed(0, COEF_WIDTH), to_signed(0, COEF_WIDTH), to_signed(0, COEF_WIDTH), to_signed(0, COEF_WIDTH), to_signed(0, COEF_WIDTH), to_signed(0, COEF_WIDTH), to_signed(0, COEF_WIDTH), to_signed(0, COEF_WIDTH), to_signed(0, COEF_WIDTH), to_signed(0, C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
F_WIDTH), to_signed(0, COEF_WIDTH), to_signed(0, COEF_WIDTH), to_signed(0, COEF_WIDTH), to_signed(0, COEF_WIDTH), to_signed(0, COEF_WIDTH), to_signed(0, COEF_WIDTH), to_signed(0, COEF_WIDTH), to_signed(0, COEF_WIDTH), to_signed(0, COEF_WIDTH), to_signed(0, COEF_WIDTH), to_signed(0, COEF_WIDTH), to_signed(0, COEF_WIDTH), to_signed(0, COEF_WIDTH), to_signed(0, COEF_WIDTH), to_signed(0, COEF_WIDTH), to_signed(0, COEF_WIDTH), to_signed(0, COEF_WIDTH), to_signed(0, COEF_WIDTH), to_signed(0, COEF_WIDTH), to_signed(0, COEF_WIDTH), to_signed(0, COEF_WIDTH), to_signed(0, COEF_WIDTH), to_signed(0, COEF_WIDTH), to_signed(0, COEF_WIDTH), to_signed(0, COEF_WIDTH), to_signed(0, COEF_WIDTH)),
        9 => (to_signed(0, COEF_WIDTH), to_signed(0, COEF_WIDTH), to_signed(0, COEF_WIDTH), to_signed(0, COEF_WIDTH), to_signed(0, COEF_WIDTH), to_signed(0, COEF_WIDTH), to_signed(0, COEF_WIDTH), to_signed(0, COEF_WIDTH), to_signed(0, COEF_WIDTH), to_signed(0, COEF_WIDTH), to_signed(0, COEF_WIDTH), to_signed(0, COEF_WIDTH), to_signed(0, COEF_WIDTH), to_signed(0, COEF_WIDTH), to_signed(0, COEF_WIDTH), to_signed(0, COEF_WIDTH), to_signed(0, COEF_WIDTH), to_signed(0, COEF_WIDTH), to_signed(0, COEF_WIDTH), to_signed(0, COEF_WIDTH), to_signed(0, COEF_WIDTH), to_signed(0, COEF_WIDTH), to_signed(683, COEF_WIDTH), to_signed(1365, COEF_WIDTH), to_signed(2047, COEF_WIDTH), to_signed(1536, COEF_WIDTH), to_signed(1024, COEF_WIDTH), to_signed(512, COEF_WIDTH), to_signed(0, COEF_WIDTH), to_signed(0, COEF_WIDTH), to_signed(0, COEF_WIDTH), to_signed(0, COEF_WIDTH), to_signed(0, COEF_WIDTH), to_signed(0, COEF_WIDTH), to_signed(0, COEF_WIDTH), to_signed(0, COEF_WIDTH), to_signed(0, COEF_WIDTH), to_signed(0, COEF_WIDTH), to_signed(0, COEF_WIDTH), to_signed(0, COEF_WIDTH), to_signed(0, COEF_WIDTH), to_signed(0, COEF_WIDTH), to_signed(0, COEF_WIDTH), to_signed(0, COEF_WIDTH), to_signed(0, COEF_WIDTH), to_signed(0, COEF_WIDTH), to_signed(0, COEF_WIDTH), to_signed(0, COEF_WIDTH), to_signed(0, COEF_WIDTH), to_signed(0, COEF_WIDTH), to_signed(0, COEF_WIDTH), to_signed(0, COEF_WIDTH), to_signed(0, COEF_WIDTH), to_signed(0, COEF_WIDTH), to_signed(0, COEF_WIDTH), to_signed(0, COEF_WIDTH), to_signed(0, C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
F_WIDTH), to_signed(0, COEF_WIDTH), to_signed(0, COEF_WIDTH), to_signed(0, COEF_WIDTH), to_signed(0, COEF_WIDTH), to_signed(0, COEF_WIDTH), to_signed(0, COEF_WIDTH), to_signed(0, COEF_WIDTH), to_signed(0, COEF_WIDTH), to_signed(0, COEF_WIDTH), to_signed(0, COEF_WIDTH), to_signed(0, COEF_WIDTH), to_signed(0, COEF_WIDTH), to_signed(0, COEF_WIDTH), to_signed(0, COEF_WIDTH), to_signed(0, COEF_WIDTH), to_signed(0, COEF_WIDTH), to_signed(0, COEF_WIDTH), to_signed(0, COEF_WIDTH), to_signed(0, COEF_WIDTH), to_signed(0, COEF_WIDTH), to_signed(0, COEF_WIDTH), to_signed(0, COEF_WIDTH), to_signed(0, COEF_WIDTH), to_signed(0, COEF_WIDTH), to_signed(0, COEF_WIDTH), to_signed(0, COEF_WIDTH)),
        10 => (to_signed(0, COEF_WIDTH), to_signed(0, COEF_WIDTH), to_signed(0, COEF_WIDTH), to_signed(0, COEF_WIDTH), to_signed(0, COEF_WIDTH), to_signed(0, COEF_WIDTH), to_signed(0, COEF_WIDTH), to_signed(0, COEF_WIDTH), to_signed(0, COEF_WIDTH), to_signed(0, COEF_WIDTH), to_signed(0, COEF_WIDTH), to_signed(0, COEF_WIDTH), to_signed(0, COEF_WIDTH), to_signed(0, COEF_WIDTH), to_signed(0, COEF_WIDTH), to_signed(0, COEF_WIDTH), to_signed(0, COEF_WIDTH), to_signed(0, COEF_WIDTH), to_signed(0, COEF_WIDTH), to_signed(0, COEF_WIDTH), to_signed(0, COEF_WIDTH), to_signed(0, COEF_WIDTH), to_signed(0, COEF_WIDTH), to_signed(0, COEF_WIDTH), to_signed(0, COEF_WIDTH), to_signed(512, COEF_WIDTH), to_signed(1024, COEF_WIDTH), to_signed(1536, COEF_WIDTH), to_signed(2047, COEF_WIDTH), to_signed(1536, COEF_WIDTH), to_signed(1024, COEF_WIDTH), to_signed(512, COEF_WIDTH), to_signed(0, COEF_WIDTH), to_signed(0, COEF_WIDTH), to_signed(0, COEF_WIDTH), to_signed(0, COEF_WIDTH), to_signed(0, COEF_WIDTH), to_signed(0, COEF_WIDTH), to_signed(0, COEF_WIDTH), to_signed(0, COEF_WIDTH), to_signed(0, COEF_WIDTH), to_signed(0, COEF_WIDTH), to_signed(0, COEF_WIDTH), to_signed(0, COEF_WIDTH), to_signed(0, COEF_WIDTH), to_signed(0, COEF_WIDTH), to_signed(0, COEF_WIDTH), to_signed(0, COEF_WIDTH), to_signed(0, COEF_WIDTH), to_signed(0, COEF_WIDTH), to_signed(0, COEF_WIDTH), to_signed(0, COEF_WIDTH), to_signed(0, COEF_WIDTH), to_signed(0, COEF_WIDTH), to_signed(0, COEF_WIDTH), to_signed(0, COEF_WIDTH), to_signed(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
 COEF_WIDTH), to_signed(0, COEF_WIDTH), to_signed(0, COEF_WIDTH), to_signed(0, COEF_WIDTH), to_signed(0, COEF_WIDTH), to_signed(0, COEF_WIDTH), to_signed(0, COEF_WIDTH), to_signed(0, COEF_WIDTH), to_signed(0, COEF_WIDTH), to_signed(0, COEF_WIDTH), to_signed(0, COEF_WIDTH), to_signed(0, COEF_WIDTH), to_signed(0, COEF_WIDTH), to_signed(0, COEF_WIDTH), to_signed(0, COEF_WIDTH), to_signed(0, COEF_WIDTH), to_signed(0, COEF_WIDTH), to_signed(0, COEF_WIDTH), to_signed(0, COEF_WIDTH), to_signed(0, COEF_WIDTH), to_signed(0, COEF_WIDTH), to_signed(0, COEF_WIDTH), to_signed(0, COEF_WIDTH), to_signed(0, COEF_WIDTH), to_signed(0, COEF_WIDTH), to_signed(0, COEF_WIDTH), to_signed(0, COEF_WIDTH)),
        11 => (to_signed(0, COEF_WIDTH), to_signed(0, COEF_WIDTH), to_signed(0, COEF_WIDTH), to_signed(0, COEF_WIDTH), to_signed(0, COEF_WIDTH), to_signed(0, COEF_WIDTH), to_signed(0, COEF_WIDTH), to_signed(0, COEF_WIDTH), to_signed(0, COEF_WIDTH), to_signed(0, COEF_WIDTH), to_signed(0, COEF_WIDTH), to_signed(0, COEF_WIDTH), to_signed(0, COEF_WIDTH), to_signed(0, COEF_WIDTH), to_signed(0, COEF_WIDTH), to_signed(0, COEF_WIDTH), to_signed(0, COEF_WIDTH), to_signed(0, COEF_WIDTH), to_signed(0, COEF_WIDTH), to_signed(0, COEF_WIDTH), to_signed(0, COEF_WIDTH), to_signed(0, COEF_WIDTH), to_signed(0, COEF_WIDTH), to_signed(0, COEF_WIDTH), to_signed(0, COEF_WIDTH), to_signed(0, COEF_WIDTH), to_signed(0, COEF_WIDTH), to_signed(0, COEF_WIDTH), to_signed(0, COEF_WIDTH), to_signed(512, COEF_WIDTH), to_signed(1024, COEF_WIDTH), to_signed(1536, COEF_WIDTH), to_signed(2047, COEF_WIDTH), to_signed(1638, COEF_WIDTH), to_signed(1229, COEF_WIDTH), to_signed(819, COEF_WIDTH), to_signed(410, COEF_WIDTH), to_signed(0, COEF_WIDTH), to_signed(0, COEF_WIDTH), to_signed(0, COEF_WIDTH), to_signed(0, COEF_WIDTH), to_signed(0, COEF_WIDTH), to_signed(0, COEF_WIDTH), to_signed(0, COEF_WIDTH), to_signed(0, COEF_WIDTH), to_signed(0, COEF_WIDTH), to_signed(0, COEF_WIDTH), to_signed(0, COEF_WIDTH), to_signed(0, COEF_WIDTH), to_signed(0, COEF_WIDTH), to_signed(0, COEF_WIDTH), to_signed(0, COEF_WIDTH), to_signed(0, COEF_WIDTH), to_signed(0, COEF_WIDTH), to_signed(0, COEF_WIDTH), to_signed(0, COEF_WIDTH), to_signe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
0, COEF_WIDTH), to_signed(0, COEF_WIDTH), to_signed(0, COEF_WIDTH), to_signed(0, COEF_WIDTH), to_signed(0, COEF_WIDTH), to_signed(0, COEF_WIDTH), to_signed(0, COEF_WIDTH), to_signed(0, COEF_WIDTH), to_signed(0, COEF_WIDTH), to_signed(0, COEF_WIDTH), to_signed(0, COEF_WIDTH), to_signed(0, COEF_WIDTH), to_signed(0, COEF_WIDTH), to_signed(0, COEF_WIDTH), to_signed(0, COEF_WIDTH), to_signed(0, COEF_WIDTH), to_signed(0, COEF_WIDTH), to_signed(0, COEF_WIDTH), to_signed(0, COEF_WIDTH), to_signed(0, COEF_WIDTH), to_signed(0, COEF_WIDTH), to_signed(0, COEF_WIDTH), to_signed(0, COEF_WIDTH), to_signed(0, COEF_WIDTH), to_signed(0, COEF_WIDTH), to_signed(0, COEF_WIDTH), to_signed(0, COEF_WIDTH)),
        12 => (to_signed(0, COEF_WIDTH), to_signed(0, COEF_WIDTH), to_signed(0, COEF_WIDTH), to_signed(0, COEF_WIDTH), to_signed(0, COEF_WIDTH), to_signed(0, COEF_WIDTH), to_signed(0, COEF_WIDTH), to_signed(0, COEF_WIDTH), to_signed(0, COEF_WIDTH), to_signed(0, COEF_WIDTH), to_signed(0, COEF_WIDTH), to_signed(0, COEF_WIDTH), to_signed(0, COEF_WIDTH), to_signed(0, COEF_WIDTH), to_signed(0, COEF_WIDTH), to_signed(0, COEF_WIDTH), to_signed(0, COEF_WIDTH), to_signed(0, COEF_WIDTH), to_signed(0, COEF_WIDTH), to_signed(0, COEF_WIDTH), to_signed(0, COEF_WIDTH), to_signed(0, COEF_WIDTH), to_signed(0, COEF_WIDTH), to_signed(0, COEF_WIDTH), to_signed(0, COEF_WIDTH), to_signed(0, COEF_WIDTH), to_signed(0, COEF_WIDTH), to_signed(0, COEF_WIDTH), to_signed(0, COEF_WIDTH), to_signed(0, COEF_WIDTH), to_signed(0, COEF_WIDTH), to_signed(0, COEF_WIDTH), to_signed(0, COEF_WIDTH), to_signed(410, COEF_WIDTH), to_signed(819, COEF_WIDTH), to_signed(1229, COEF_WIDTH), to_signed(1638, COEF_WIDTH), to_signed(2047, COEF_WIDTH), to_signed(1536, COEF_WIDTH), to_signed(1024, COEF_WIDTH), to_signed(512, COEF_WIDTH), to_signed(0, COEF_WIDTH), to_signed(0, COEF_WIDTH), to_signed(0, COEF_WIDTH), to_signed(0, COEF_WIDTH), to_signed(0, COEF_WIDTH), to_signed(0, COEF_WIDTH), to_signed(0, COEF_WIDTH), to_signed(0, COEF_WIDTH), to_signed(0, COEF_WIDTH), to_signed(0, COEF_WIDTH), to_signed(0, COEF_WIDTH), to_signed(0, COEF_WIDTH), to_signed(0, COEF_WIDTH), to_signed(0, COEF_WIDTH), to_signed(0, COEF_WIDTH), to_signe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
0, COEF_WIDTH), to_signed(0, COEF_WIDTH), to_signed(0, COEF_WIDTH), to_signed(0, COEF_WIDTH), to_signed(0, COEF_WIDTH), to_signed(0, COEF_WIDTH), to_signed(0, COEF_WIDTH), to_signed(0, COEF_WIDTH), to_signed(0, COEF_WIDTH), to_signed(0, COEF_WIDTH), to_signed(0, COEF_WIDTH), to_signed(0, COEF_WIDTH), to_signed(0, COEF_WIDTH), to_signed(0, COEF_WIDTH), to_signed(0, COEF_WIDTH), to_signed(0, COEF_WIDTH), to_signed(0, COEF_WIDTH), to_signed(0, COEF_WIDTH), to_signed(0, COEF_WIDTH), to_signed(0, COEF_WIDTH), to_signed(0, COEF_WIDTH), to_signed(0, COEF_WIDTH), to_signed(0, COEF_WIDTH), to_signed(0, COEF_WIDTH), to_signed(0, COEF_WIDTH), to_signed(0, COEF_WIDTH), to_signed(0, COEF_WIDTH)),
        13 => (to_signed(0, COEF_WIDTH), to_signed(0, COEF_WIDTH), to_signed(0, COEF_WIDTH), to_signed(0, COEF_WIDTH), to_signed(0, COEF_WIDTH), to_signed(0, COEF_WIDTH), to_signed(0, COEF_WIDTH), to_signed(0, COEF_WIDTH), to_signed(0, COEF_WIDTH), to_signed(0, COEF_WIDTH), to_signed(0, COEF_WIDTH), to_signed(0, COEF_WIDTH), to_signed(0, COEF_WIDTH), to_signed(0, COEF_WIDTH), to_signed(0, COEF_WIDTH), to_signed(0, COEF_WIDTH), to_signed(0, COEF_WIDTH), to_signed(0, COEF_WIDTH), to_signed(0, COEF_WIDTH), to_signed(0, COEF_WIDTH), to_signed(0, COEF_WIDTH), to_signed(0, COEF_WIDTH), to_signed(0, COEF_WIDTH), to_signed(0, COEF_WIDTH), to_signed(0, COEF_WIDTH), to_signed(0, COEF_WIDTH), to_signed(0, COEF_WIDTH), to_signed(0, COEF_WIDTH), to_signed(0, COEF_WIDTH), to_signed(0, COEF_WIDTH), to_signed(0, COEF_WIDTH), to_signed(0, COEF_WIDTH), to_signed(0, COEF_WIDTH), to_signed(0, COEF_WIDTH), to_signed(0, COEF_WIDTH), to_signed(0, COEF_WIDTH), to_signed(0, COEF_WIDTH), to_signed(0, COEF_WIDTH), to_signed(512, COEF_WIDTH), to_signed(1024, COEF_WIDTH), to_signed(1536, COEF_WIDTH), to_signed(2047, COEF_WIDTH), to_signed(1707, COEF_WIDTH), to_signed(1365, COEF_WIDTH), to_signed(1024, COEF_WIDTH), to_signed(683, COEF_WIDTH), to_signed(341, COEF_WIDTH), to_signed(0, COEF_WIDTH), to_signed(0, COEF_WIDTH), to_signed(0, COEF_WIDTH), to_signed(0, COEF_WIDTH), to_signed(0, COEF_WIDTH), to_signed(0, COEF_WIDTH), to_signed(0, COEF_WIDTH), to_signed(0, COEF_WIDTH), to_signed(0, COEF_WIDTH), to_si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
ed(0, COEF_WIDTH), to_signed(0, COEF_WIDTH), to_signed(0, COEF_WIDTH), to_signed(0, COEF_WIDTH), to_signed(0, COEF_WIDTH), to_signed(0, COEF_WIDTH), to_signed(0, COEF_WIDTH), to_signed(0, COEF_WIDTH), to_signed(0, COEF_WIDTH), to_signed(0, COEF_WIDTH), to_signed(0, COEF_WIDTH), to_signed(0, COEF_WIDTH), to_signed(0, COEF_WIDTH), to_signed(0, COEF_WIDTH), to_signed(0, COEF_WIDTH), to_signed(0, COEF_WIDTH), to_signed(0, COEF_WIDTH), to_signed(0, COEF_WIDTH), to_signed(0, COEF_WIDTH), to_signed(0, COEF_WIDTH), to_signed(0, COEF_WIDTH), to_signed(0, COEF_WIDTH), to_signed(0, COEF_WIDTH), to_signed(0, COEF_WIDTH), to_signed(0, COEF_WIDTH), to_signed(0, COEF_WIDTH), to_signed(0, COEF_WIDTH)),
        14 => (to_signed(0, COEF_WIDTH), to_signed(0, COEF_WIDTH), to_signed(0, COEF_WIDTH), to_signed(0, COEF_WIDTH), to_signed(0, COEF_WIDTH), to_signed(0, COEF_WIDTH), to_signed(0, COEF_WIDTH), to_signed(0, COEF_WIDTH), to_signed(0, COEF_WIDTH), to_signed(0, COEF_WIDTH), to_signed(0, COEF_WIDTH), to_signed(0, COEF_WIDTH), to_signed(0, COEF_WIDTH), to_signed(0, COEF_WIDTH), to_signed(0, COEF_WIDTH), to_signed(0, COEF_WIDTH), to_signed(0, COEF_WIDTH), to_signed(0, COEF_WIDTH), to_signed(0, COEF_WIDTH), to_signed(0, COEF_WIDTH), to_signed(0, COEF_WIDTH), to_signed(0, COEF_WIDTH), to_signed(0, COEF_WIDTH), to_signed(0, COEF_WIDTH), to_signed(0, COEF_WIDTH), to_signed(0, COEF_WIDTH), to_signed(0, COEF_WIDTH), to_signed(0, COEF_WIDTH), to_signed(0, COEF_WIDTH), to_signed(0, COEF_WIDTH), to_signed(0, COEF_WIDTH), to_signed(0, COEF_WIDTH), to_signed(0, COEF_WIDTH), to_signed(0, COEF_WIDTH), to_signed(0, COEF_WIDTH), to_signed(0, COEF_WIDTH), to_signed(0, COEF_WIDTH), to_signed(0, COEF_WIDTH), to_signed(0, COEF_WIDTH), to_signed(0, COEF_WIDTH), to_signed(0, COEF_WIDTH), to_signed(0, COEF_WIDTH), to_signed(341, COEF_WIDTH), to_signed(683, COEF_WIDTH), to_signed(1024, COEF_WIDTH), to_signed(1365, COEF_WIDTH), to_signed(1707, COEF_WIDTH), to_signed(2047, COEF_WIDTH), to_signed(1638, COEF_WIDTH), to_signed(1229, COEF_WIDTH), to_signed(819, COEF_WIDTH), to_signed(410, COEF_WIDTH), to_signed(0, COEF_WIDTH), to_signed(0, COEF_WIDTH), to_signed(0, COEF_WIDTH), to_signed(0, COEF_WIDTH), to_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
gned(0, COEF_WIDTH), to_signed(0, COEF_WIDTH), to_signed(0, COEF_WIDTH), to_signed(0, COEF_WIDTH), to_signed(0, COEF_WIDTH), to_signed(0, COEF_WIDTH), to_signed(0, COEF_WIDTH), to_signed(0, COEF_WIDTH), to_signed(0, COEF_WIDTH), to_signed(0, COEF_WIDTH), to_signed(0, COEF_WIDTH), to_signed(0, COEF_WIDTH), to_signed(0, COEF_WIDTH), to_signed(0, COEF_WIDTH), to_signed(0, COEF_WIDTH), to_signed(0, COEF_WIDTH), to_signed(0, COEF_WIDTH), to_signed(0, COEF_WIDTH), to_signed(0, COEF_WIDTH), to_signed(0, COEF_WIDTH), to_signed(0, COEF_WIDTH), to_signed(0, COEF_WIDTH), to_signed(0, COEF_WIDTH), to_signed(0, COEF_WIDTH), to_signed(0, COEF_WIDTH), to_signed(0, COEF_WIDTH), to_signed(0, COEF_WIDTH)),
        15 => (to_signed(0, COEF_WIDTH), to_signed(0, COEF_WIDTH), to_signed(0, COEF_WIDTH), to_signed(0, COEF_WIDTH), to_signed(0, COEF_WIDTH), to_signed(0, COEF_WIDTH), to_signed(0, COEF_WIDTH), to_signed(0, COEF_WIDTH), to_signed(0, COEF_WIDTH), to_signed(0, COEF_WIDTH), to_signed(0, COEF_WIDTH), to_signed(0, COEF_WIDTH), to_signed(0, COEF_WIDTH), to_signed(0, COEF_WIDTH), to_signed(0, COEF_WIDTH), to_signed(0, COEF_WIDTH), to_signed(0, COEF_WIDTH), to_signed(0, COEF_WIDTH), to_signed(0, COEF_WIDTH), to_signed(0, COEF_WIDTH), to_signed(0, COEF_WIDTH), to_signed(0, COEF_WIDTH), to_signed(0, COEF_WIDTH), to_signed(0, COEF_WIDTH), to_signed(0, COEF_WIDTH), to_signed(0, COEF_WIDTH), to_signed(0, COEF_WIDTH), to_signed(0, COEF_WIDTH), to_signed(0, COEF_WIDTH), to_signed(0, COEF_WIDTH), to_signed(0, COEF_WIDTH), to_signed(0, COEF_WIDTH), to_signed(0, COEF_WIDTH), to_signed(0, COEF_WIDTH), to_signed(0, COEF_WIDTH), to_signed(0, COEF_WIDTH), to_signed(0, COEF_WIDTH), to_signed(0, COEF_WIDTH), to_signed(0, COEF_WIDTH), to_signed(0, COEF_WIDTH), to_signed(0, COEF_WIDTH), to_signed(0, COEF_WIDTH), to_signed(0, COEF_WIDTH), to_signed(0, COEF_WIDTH), to_signed(0, COEF_WIDTH), to_signed(0, COEF_WIDTH), to_signed(0, COEF_WIDTH), to_signed(0, COEF_WIDTH), to_signed(410, COEF_WIDTH), to_signed(819, COEF_WIDTH), to_signed(1229, COEF_WIDTH), to_signed(1638, COEF_WIDTH), to_signed(2047, COEF_WIDTH), to_signed(1707, COEF_WIDTH), to_signed(1365, COEF_WIDTH), to_signed(1024, COEF_WIDTH), to_sign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
gned(0, COEF_WIDTH), to_signed(0, COEF_WIDTH), to_signed(0, COEF_WIDTH), to_signed(0, COEF_WIDTH), to_signed(0, COEF_WIDTH), to_signed(0, COEF_WIDTH), to_signed(0, COEF_WIDTH), to_signed(0, COEF_WIDTH), to_signed(0, COEF_WIDTH), to_signed(0, COEF_WIDTH), to_signed(0, COEF_WIDTH), to_signed(0, COEF_WIDTH), to_signed(0, COEF_WIDTH), to_signed(0, COEF_WIDTH), to_signed(0, COEF_WIDTH), to_signed(0, COEF_WIDTH), to_signed(0, COEF_WIDTH), to_signed(0, COEF_WIDTH), to_signed(0, COEF_WIDTH), to_signed(0, COEF_WIDTH), to_signed(0, COEF_WIDTH), to_signed(0, COEF_WIDTH), to_signed(0, COEF_WIDTH), to_signed(0, COEF_WIDTH), to_signed(0, COEF_WIDTH), to_signed(0, COEF_WIDTH), to_signed(0, COEF_WIDTH)),
        16 => (to_signed(0, COEF_WIDTH), to_signed(0, COEF_WIDTH), to_signed(0, COEF_WIDTH), to_signed(0, COEF_WIDTH), to_signed(0, COEF_WIDTH), to_signed(0, COEF_WIDTH), to_signed(0, COEF_WIDTH), to_signed(0, COEF_WIDTH), to_signed(0, COEF_WIDTH), to_signed(0, COEF_WIDTH), to_signed(0, COEF_WIDTH), to_signed(0, COEF_WIDTH), to_signed(0, COEF_WIDTH), to_signed(0, COEF_WIDTH), to_signed(0, COEF_WIDTH), to_signed(0, COEF_WIDTH), to_signed(0, COEF_WIDTH), to_signed(0, COEF_WIDTH), to_signed(0, COEF_WIDTH), to_signed(0, COEF_WIDTH), to_signed(0, COEF_WIDTH), to_signed(0, COEF_WIDTH), to_signed(0, COEF_WIDTH), to_signed(0, COEF_WIDTH), to_signed(0, COEF_WIDTH), to_signed(0, COEF_WIDTH), to_signed(0, COEF_WIDTH), to_signed(0, COEF_WIDTH), to_signed(0, COEF_WIDTH), to_signed(0, COEF_WIDTH), to_signed(0, COEF_WIDTH), to_signed(0, COEF_WIDTH), to_signed(0, COEF_WIDTH), to_signed(0, COEF_WIDTH), to_signed(0, COEF_WIDTH), to_signed(0, COEF_WIDTH), to_signed(0, COEF_WIDTH), to_signed(0, COEF_WIDTH), to_signed(0, COEF_WIDTH), to_signed(0, COEF_WIDTH), to_signed(0, COEF_WIDTH), to_signed(0, COEF_WIDTH), to_signed(0, COEF_WIDTH), to_signed(0, COEF_WIDTH), to_signed(0, COEF_WIDTH), to_signed(0, COEF_WIDTH), to_signed(0, COEF_WIDTH), to_signed(0, COEF_WIDTH), to_signed(0, COEF_WIDTH), to_signed(0, COEF_WIDTH), to_signed(0, COEF_WIDTH), to_signed(0, COEF_WIDTH), to_signed(0, COEF_WIDTH), to_signed(341, COEF_WIDTH), to_signed(683, COEF_WIDTH), to_signed(1024, COEF_WIDTH), to_signed(1365, COEF_W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
to_signed(0, COEF_WIDTH), to_signed(0, COEF_WIDTH), to_signed(0, COEF_WIDTH), to_signed(0, COEF_WIDTH), to_signed(0, COEF_WIDTH), to_signed(0, COEF_WIDTH), to_signed(0, COEF_WIDTH), to_signed(0, COEF_WIDTH), to_signed(0, COEF_WIDTH), to_signed(0, COEF_WIDTH), to_signed(0, COEF_WIDTH), to_signed(0, COEF_WIDTH), to_signed(0, COEF_WIDTH), to_signed(0, COEF_WIDTH), to_signed(0, COEF_WIDTH), to_signed(0, COEF_WIDTH), to_signed(0, COEF_WIDTH), to_signed(0, COEF_WIDTH), to_signed(0, COEF_WIDTH), to_signed(0, COEF_WIDTH), to_signed(0, COEF_WIDTH), to_signed(0, COEF_WIDTH), to_signed(0, COEF_WIDTH), to_signed(0, COEF_WIDTH), to_signed(0, COEF_WIDTH), to_signed(0, COEF_WIDTH), to_signed(0, COEF_WIDTH)),
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
